sdeghuee/ThermistorBoard/Astranis.pdf

# Table of Contents

# Thermistor Temp Calculations

A = 1.2870e-3;
B = 2.3585e-4;
C = 9.4346e-8;
R = 6e3;
T = 1/ (A +B * log(R) + C * (log(R))^3); T = T - 273.15;

# Thermistor R Calculations

clear
clc
A = 1.2870e-3;
B = 2.3585e-4;
C = 9.4346e-8;
T = -80:.1:250;
T = T + 273.15;
alpha = ((A-(1./T))./C);
beta = sqrt(((B./(3*C))^3) + (alpha.^2/4));

R = exp((beta-(alpha./2)).^(1/3) - ((beta+(alpha./2)).^(1/3))); subplot(2,1,1)
plot(T-273.15,R)
title('Resistance over Temp')
xlabel('Degrees (C)')
ylabel('Resistance (Ohms)') dR = diff(R);
subplot(2,1,2)
plot(T(2:end)-273.15,abs(dR)); title('Magnitude of dR/DT') xlabel('Degrees (C)')
ylabel('dR/dT')
[dRmin, I] = min(abs(dR));
smallestSwing = T(I) - 273.15; %From this the worst case for ADC is at high temps deltaRsmall = R(end-7) - R(end);

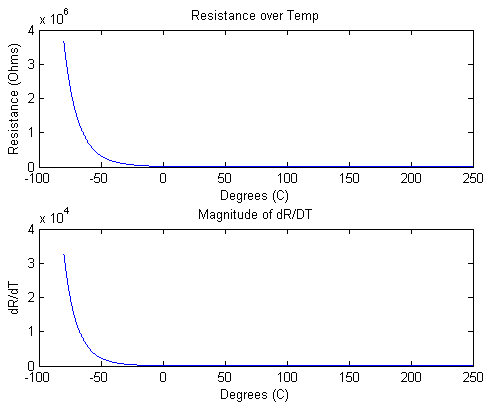
[picture p18: figure]

# ADC Resolution Choice

Rstatic = 500e3;
adcResreq = 1.8*(R(end-7) / (Rstatic + R(end-7)) - R(end)/(Rstatic + R(end))); adcRes = 1.8 / (2^16);
fprintf('ADC Resolution is good True/False: %d\n',adcResreq > adcRes)

ADC Resolution is good True/False: 0

# ADC SCLK Choice

bitpch = 24;
fullsample = bitpch * 24 /8; fclk = 27e6;
fdata = fclk / 2560;

# Power Calculations

Vin = 28;
Vlogic = 1.8;
Vhigh = 5;
% Microcontroller
Imicro = 2.5e-3;
% Thermocouples

Rmin = Rstatic + R(end);
Idivide = (Vlogic / Rmin)*24; % ADCs Vsupply = 5V, 1V8
Iadc1V8 = 2.5e-3 + .035e-3; Iadc5 = 9e-3;
%RS485 Vsupply = 5V
Irs485 = 28e-3;
%Level Shifter
Ipshift = 18e-6;
% Switching Supply Calculations efficiencya = .75;
efficiencyp = .75;
% Total Power Calculation (active)
P1V8 = Vhigh*(24*Idivide + Imicro + 3*Iadc1V8 + 1*Ipshift)/efficiencya; P5 = Vhigh*(Irs485 + 3*Iadc5 + 3*Ipshift)/efficiencya;
fprintf('Power Consumption(active) 1V8: %1.2f Watts\n',P1V8) fprintf('Power Consumption(active) 5: %1.2f Watts\n',P5)
fprintf('Power Consumption(active) Total: %1.2f Watts\n',P1V8 + P5)
% Total Power Calculation (passive)
Pp1V8 = Vhigh*(24*Idivide + Imicro + 3*Iadc1V8 + 1*Ipshift)/efficiencyp; Pp5 = Vhigh*(Irs485 + 3*Ipshift)/efficiencyp;
fprintf('Power Consumption(passive) 1V8: %1.2f Watts\n',Pp1V8) fprintf('Power Consumption(passive) 5: %1.2f Watts\n',Pp5) fprintf('Power Consumption(passive) Total: %1.2f Watts\n',Pp1V8 + Pp5)

Power Consumption(active) 1V8: 0.08 Watts Power Consumption(active) 5: 0.37 Watts Power Consumption(active) Total: 0.45 Watts Power Consumption(passive) 1V8: 0.08 Watts Power Consumption(passive) 5: 0.19 Watts Power Consumption(passive) Total: 0.27 Watts

Published with MATLAB® R2014a
