sdeghuee/ThermistorBoard/Unidirectional_lvlshift.asc

Q1: npn; 2N2222
Q2: npn; 2N2222
R1: res; 100k
R2: res; 100k
R3: res; 100k
V1: voltage; 1.8
V2: voltage; PULSE(0 5 0 0 0 10m 20m 100)
Named nets: 0, LO, LI, noninv
.tran 100m
