sdeghuee/ThermistorBoard/(list of files, drawings)

Other design files:
ADC.SchDoc
Astranis.SchDoc
Astranis_Thermocouple.PrjPcb
M12_Connector.SchDoc
MSP430.SchDoc
Power.SchDoc
RS485.SchDoc
Unidirectional_lvlshifter.SchDoc
